MSF3Dprinting/pipe-cross-clamp/tools/sweep_report_body_bolts_2026-09-26.txt

sweep report — pipe_cross_clamp.scad v1.0 (md5 222455b7b1ace6a696c72f4b03150e54) — config body_bolts — 2026-09-26
OpenSCAD 2021.01; check_stl.py on every PASS case. Run in two passes on the same file version (the first pass was
interrupted when the conversation turn ended; the second ran only the unfinished cases). "2 separate pieces" warnings
are expected: the seats split the part below the web.
TOTAL 54 cases: PASS 54  GUARD 0  FAIL 0

PASS   defaults                                   24.2s  check_stl warn: section at Z = 2.0: 2 separate pieces — expected if the part has several legs or walls here, a defect if the zone should be one piece; section at Z = 10.0: 2 separate pieces — expected if the part has several legs or walls here, a defect if the zone should be one piece; section at Z = 40.0: 2 separate pieces — expected if the part has several legs or walls here, a defect if the zone should be one piece
PASS   part=cap1                                  24.1s  check_stl warn: section at Z = 2.0: 2 separate pieces — expected if the part has several legs or walls here, a defect if the zone should be one piece; section at Z = 10.0: 2 separate pieces — expected if the part has several legs or walls here, a defect if the zone should be one piece; section at Z = 40.0: 2 separate pieces — expected if the part has several legs or walls here, a defect if the zone should be one piece
PASS   part=cap2                                  23.9s  check_stl warn: section at Z = 2.0: 2 separate pieces — expected if the part has several legs or walls here, a defect if the zone should be one piece; section at Z = 10.0: 2 separate pieces — expected if the part has several legs or walls here, a defect if the zone should be one piece; section at Z = 40.0: 2 separate pieces — expected if the part has several legs or walls here, a defect if the zone should be one piece
PASS   part=gauge                                 24.5s  check_stl warn: section at Z = 2.0: 2 separate pieces — expected if the part has several legs or walls here, a defect if the zone should be one piece; section at Z = 10.0: 2 separate pieces — expected if the part has several legs or walls here, a defect if the zone should be one piece; section at Z = 40.0: 2 separate pieces — expected if the part has several legs or walls here, a defect if the zone should be one piece
PASS   closure=zipties                            23.6s  check_stl warn: section at Z = 2.0: 2 separate pieces — expected if the part has several legs or walls here, a defect if the zone should be one piece; section at Z = 10.0: 2 separate pieces — expected if the part has several legs or walls here, a defect if the zone should be one piece; section at Z = 40.0: 2 separate pieces — expected if the part has several legs or walls here, a defect if the zone should be one piece
PASS   pipe1_d=min(10)                            24.0s  check_stl warn: section at Z = 2.0: 2 separate pieces — expected if the part has several legs or walls here, a defect if the zone should be one piece
PASS   pipe1_d=max(60)                            26.6s  check_stl warn: section at Z = 2.0: 2 separate pieces — expected if the part has several legs or walls here, a defect if the zone should be one piece; section at Z = 10.0: 2 separate pieces — expected if the part has several legs or walls here, a defect if the zone should be one piece; section at Z = 30.0: 2 separate pieces — expected if the part has several legs or walls here, a defect if the zone should be one piece; section at Z = 40.0: 2 separate pieces — expected if the part has several legs or walls here, a defect if the zone should be one piece
PASS   pipe2_d=min(10)                            27.2s  check_stl warn: section at Z = 2.0: 2 separate pieces — expected if the part has several legs or walls here, a defect if the zone should be one piece; section at Z = 10.0: 2 separate pieces — expected if the part has several legs or walls here, a defect if the zone should be one piece; section at Z = 30.0: 2 separate pieces — expected if the part has several legs or walls here, a defect if the zone should be one piece
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
PASS   corner_r=max(8)                             7.5s  check_stl warn: section at Z = 2.0: 2 separate pieces — expected if the part has several legs or walls here, a defect if the zone should be one piece; section at Z = 10.0: 2 separate pieces — expected if the part has several legs or walls here, a defect if the zone should be one piece; section at Z = 40.0: 2 separate pieces — expected if the part has several legs or walls here, a defect if the zone should be one piece
PASS   show_ghosts=false                           7.4s  check_stl warn: section at Z = 2.0: 2 separate pieces — expected if the part has several legs or walls here, a defect if the zone should be one piece; section at Z = 10.0: 2 separate pieces — expected if the part has several legs or walls here, a defect if the zone should be one piece; section at Z = 40.0: 2 separate pieces — expected if the part has several legs or walls here, a defect if the zone should be one piece
