MSF3Dprinting/pipe-cross-clamp/tools/sweep_report_body_zipties_2026-09-26.txt

sweep report — pipe_cross_clamp.scad v1.0 (md5 222455b7b1ace6a696c72f4b03150e54) — config body_zipties — 2026-09-26
OpenSCAD 2021.01; check_stl.py on every PASS case. Run in two passes on the same file version (the first pass was
interrupted when the conversation turn ended; the second ran only the unfinished cases). "2 separate pieces" warnings
are expected: the seats split the part below the web.
TOTAL 54 cases: PASS 54  GUARD 0  FAIL 0

PASS   defaults                                   27.1s  check_stl warn: section at Z = 2.0: 2 separate pieces — expected if the part has several legs or walls here, a defect if the zone should be one piece; section at Z = 10.0: 2 separate pieces — expected if the part has several legs or walls here, a defect if the zone should be one piece; section at Z = 58.0: 2 separate pieces — expected if the part has several legs or walls here, a defect if the zone should be one piece
PASS   part=cap1                                  26.9s  check_stl warn: section at Z = 2.0: 2 separate pieces — expected if the part has several legs or walls here, a defect if the zone should be one piece; section at Z = 10.0: 2 separate pieces — expected if the part has several legs or walls here, a defect if the zone should be one piece; section at Z = 58.0: 2 separate pieces — expected if the part has several legs or walls here, a defect if the zone should be one piece
PASS   part=cap2                                  27.0s  check_stl warn: section at Z = 2.0: 2 separate pieces — expected if the part has several legs or walls here, a defect if the zone should be one piece; section at Z = 10.0: 2 separate pieces — expected if the part has several legs or walls here, a defect if the zone should be one piece; section at Z = 58.0: 2 separate pieces — expected if the part has several legs or walls here, a defect if the zone should be one piece
PASS   part=gauge                                 27.3s  check_stl warn: section at Z = 2.0: 2 separate pieces — expected if the part has several legs or walls here, a defect if the zone should be one piece; section at Z = 10.0: 2 separate pieces — expected if the part has several legs or walls here, a defect if the zone should be one piece; section at Z = 58.0: 2 separate pieces — expected if the part has several legs or walls here, a defect if the zone should be one piece
PASS   closure=zipties                            27.2s  check_stl warn: section at Z = 2.0: 2 separate pieces — expected if the part has several legs or walls here, a defect if the zone should be one piece; section at Z = 10.0: 2 separate pieces — expected if the part has several legs or walls here, a defect if the zone should be one piece; section at Z = 58.0: 2 separate pieces — expected if the part has several legs or walls here, a defect if the zone should be one piece
PASS   pipe1_d=min(10)                            26.3s  check_stl warn: section at Z = 2.0: 2 separate pieces — expected if the part has several legs or walls here, a defect if the zone should be one piece
PASS   pipe1_d=max(60)                            27.6s  check_stl warn: small bed contact for a tall part — add brim ears (brim_ear_d) or widen the base; section at Z = 2.0: 2 separate pieces — expected if the part has several legs or walls here, a defect if the zone should be one piece; section at Z = 10.0: 2 separate pieces — expected if the part has several legs or walls here, a defect if the zone should be one piece; section at Z = 30.0: 2 separate pieces — expected if the part has several legs or walls here, a defect if the zone should be one piece
PASS   pipe2_d=min(10)                            30.9s  check_stl warn: section at Z = 2.0: 2 separate pieces — expected if the part has several legs or walls here, a defect if the zone should be one piece; section at Z = 10.0: 2 separate pieces — expected if the part has several legs or walls here, a defect if the zone should be one piece
PASS   pipe2_d=max(60)                            30.7s  check_stl warn: small bed contact for a tall part — add brim ears (brim_ear_d) or widen the base; section at Z = 2.0: 2 separate pieces — expected if the part has several legs or walls here, a defect if the zone should be one piece; section at Z = 10.0: 2 separate pieces — expected if the part has several legs or walls here, a defect if the zone should be one piece
PASS   angle=min(0)                               29.7s  check_stl warn: section at Z = 2.0: 2 separate pieces — expected if the part has several legs or walls here, a defect if the zone should be one piece; section at Z = 10.0: 2 separate pieces — expected if the part has several legs or walls here, a defect if the zone should be one piece; section at Z = 50.0: 2 separate pieces — expected if the part has several legs or walls here, a defect if the zone should be one piece
PASS   angle=max(90)                              31.0s  check_stl warn: section at Z = 2.0: 2 separate pieces — expected if the part has several legs or walls here, a defect if the zone should be one piece; section at Z = 10.0: 2 separate pieces — expected if the part has several legs or walls here, a defect if the zone should be one piece; section at Z = 58.0: 2 separate pieces — expected if the part has several legs or walls here, a defect if the zone should be one piece
PASS   seat_len1=min(20)                          31.3s  check_stl warn: small bed contact for a tall part — add brim ears (brim_ear_d) or widen the base; section at Z = 2.0: 2 separate pieces — expected if the part has several legs or walls here, a defect if the zone should be one piece; section at Z = 10.0: 2 separate pieces — expected if the part has several legs or walls here, a defect if the zone should be one piece; section at Z = 58.0: 2 separate pieces — expected if the part has several legs or walls here, a defect if the zone should be one piece
PASS   seat_len1=max(80)                          29.0s  check_stl warn: section at Z = 2.0: 2 separate pieces — expected if the part has several legs or walls here, a defect if the zone should be one piece; section at Z = 10.0: 2 separate pieces — expected if the part has several legs or walls here, a defect if the zone should be one piece; section at Z = 50.0: 2 separate pieces — expected if the part has several legs or walls here, a defect if the zone should be one piece
PASS   seat_len2=min(20)                          31.9s  check_stl warn: section at Z = 2.0: 2 separate pieces — expected if the part has several legs or walls here, a defect if the zone should be one piece; section at Z = 10.0: 2 separate pieces — expected if the part has several legs or walls here, a defect if the zone should be one piece; section at Z = 58.0: 2 separate pieces — expected if the part has several legs or walls here, a defect if the zone should be one piece
PASS   seat_len2=max(80)                          31.7s  check_stl warn: small bed contact for a tall part — add brim ears (brim_ear_d) or widen the base; section at Z = 2.0: 2 separate pieces — expected if the part has several legs or walls here, a defect if the zone should be one piece; section at Z = 10.0: 2 separate pieces — expected if the part has several legs or walls here, a defect if the zone should be one piece
PASS   v_angle=min(60)                            28.5s  check_stl warn: section at Z = 2.0: 2 separate pieces — expected if the part has several legs or walls here, a defect if the zone should be one piece; section at Z = 10.0: 2 separate pieces — expected if the part has several legs or walls here, a defect if the zone should be one piece; section at Z = 30.0: 2 separate pieces — expected if the part has several legs or walls here, a defect if the zone should be one piece
PASS   v_angle=max(90)                            32.0s  check_stl warn: section at Z = 2.0: 2 separate pieces — expected if the part has several legs or walls here, a defect if the zone should be one piece; section at Z = 10.0: 2 separate pieces — expected if the part has several legs or walls here, a defect if the zone should be one piece; section at Z = 58.0: 2 separate pieces — expected if the part has several legs or walls here, a defect if the zone should be one piece
PASS   seat_clear=min(0.5)                        31.0s  check_stl warn: section at Z = 2.0: 2 separate pieces — expected if the part has several legs or walls here, a defect if the zone should be one piece; section at Z = 10.0: 2 separate pieces — expected if the part has several legs or walls here, a defect if the zone should be one piece; section at Z = 50.0: 2 separate pieces — expected if the part has several legs or walls here, a defect if the zone should be one piece; section at Z = 58.0: 2 separate pieces — expected if the part has several legs or walls here, a defect if the zone should be one piece
PASS   seat_clear=max(3)                          31.0s  check_stl warn: small bed contact for a tall part — add brim ears (brim_ear_d) or widen the base; section at Z = 2.0: 2 separate pieces — expected if the part has several legs or walls here, a defect if the zone should be one piece; section at Z = 10.0: 2 separate pieces — expected if the part has several legs or walls here, a defect if the zone should be one piece; section at Z = 58.0: 2 separate pieces — expected if the part has several legs or walls here, a defect if the zone should be one piece
PASS   clamp_gap=min(1)                           31.9s  check_stl warn: section at Z = 2.0: 2 separate pieces — expected if the part has several legs or walls here, a defect if the zone should be one piece; section at Z = 10.0: 2 separate pieces — expected if the part has several legs or walls here, a defect if the zone should be one piece; section at Z = 58.0: 2 separate pieces — expected if the part has several legs or walls here, a defect if the zone should be one piece
PASS   clamp_gap=max(5)                           31.6s  check_stl warn: section at Z = 2.0: 2 separate pieces — expected if the part has several legs or walls here, a defect if the zone should be one piece; section at Z = 10.0: 2 separate pieces — expected if the part has several legs or walls here, a defect if the zone should be one piece; section at Z = 50.0: 2 separate pieces — expected if the part has several legs or walls here, a defect if the zone should be one piece; section at Z = 58.0: 2 separate pieces — expected if the part has several legs or walls here, a defect if the zone should be one piece
PASS   floor_relief=min(0.2)                      31.3s  check_stl warn: section at Z = 2.0: 2 separate pieces — expected if the part has several legs or walls here, a defect if the zone should be one piece; section at Z = 10.0: 2 separate pieces — expected if the part has several legs or walls here, a defect if the zone should be one piece; section at Z = 58.0: 2 separate pieces — expected if the part has several legs or walls here, a defect if the zone should be one piece
PASS   floor_relief=max(2)                        31.2s  check_stl warn: section at Z = 2.0: 2 separate pieces — expected if the part has several legs or walls here, a defect if the zone should be one piece; section at Z = 10.0: 2 separate pieces — expected if the part has several legs or walls here, a defect if the zone should be one piece; section at Z = 58.0: 2 separate pieces — expected if the part has several legs or walls here, a defect if the zone should be one piece
PASS   bolt_clear=min(0.2)                        31.5s  check_stl warn: section at Z = 2.0: 2 separate pieces — expected if the part has several legs or walls here, a defect if the zone should be one piece; section at Z = 10.0: 2 separate pieces — expected if the part has several legs or walls here, a defect if the zone should be one piece; section at Z = 58.0: 2 separate pieces — expected if the part has several legs or walls here, a defect if the zone should be one piece
PASS   bolt_clear=max(1.2)                        31.3s  check_stl warn: section at Z = 2.0: 2 separate pieces — expected if the part has several legs or walls here, a defect if the zone should be one piece; section at Z = 10.0: 2 separate pieces — expected if the part has several legs or walls here, a defect if the zone should be one piece; section at Z = 58.0: 2 separate pieces — expected if the part has several legs or walls here, a defect if the zone should be one piece
PASS   tie_w=min(2.5)                             31.8s  check_stl warn: section at Z = 2.0: 2 separate pieces — expected if the part has several legs or walls here, a defect if the zone should be one piece; section at Z = 10.0: 2 separate pieces — expected if the part has several legs or walls here, a defect if the zone should be one piece; section at Z = 50.0: 2 separate pieces — expected if the part has several legs or walls here, a defect if the zone should be one piece
PASS   tie_w=max(9)                               32.2s  check_stl warn: small bed contact for a tall part — add brim ears (brim_ear_d) or widen the base; section at Z = 2.0: 2 separate pieces — expected if the part has several legs or walls here, a defect if the zone should be one piece; section at Z = 10.0: 2 separate pieces — expected if the part has several legs or walls here, a defect if the zone should be one piece; section at Z = 58.0: 2 separate pieces — expected if the part has several legs or walls here, a defect if the zone should be one piece
PASS   tie_t=min(0.8)                             32.0s  check_stl warn: section at Z = 2.0: 2 separate pieces — expected if the part has several legs or walls here, a defect if the zone should be one piece; section at Z = 10.0: 2 separate pieces — expected if the part has several legs or walls here, a defect if the zone should be one piece; section at Z = 50.0: 2 separate pieces — expected if the part has several legs or walls here, a defect if the zone should be one piece; section at Z = 58.0: 2 separate pieces — expected if the part has several legs or walls here, a defect if the zone should be one piece
PASS   tie_t=max(2.5)                             31.0s  check_stl warn: section at Z = 2.0: 2 separate pieces — expected if the part has several legs or walls here, a defect if the zone should be one piece; section at Z = 10.0: 2 separate pieces — expected if the part has several legs or walls here, a defect if the zone should be one piece; section at Z = 58.0: 2 separate pieces — expected if the part has several legs or walls here, a defect if the zone should be one piece
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
PASS   tie_bend_r=max(10)                         13.4s  check_stl warn: section at Z = 2.0: 2 separate pieces — expected if the part has several legs or walls here, a defect if the zone should be one piece; section at Z = 10.0: 2 separate pieces — expected if the part has several legs or walls here, a defect if the zone should be one piece; section at Z = 58.0: 2 separate pieces — expected if the part has several legs or walls here, a defect if the zone should be one piece
PASS   corner_r=min(2)                            12.8s  check_stl warn: section at Z = 2.0: 2 separate pieces — expected if the part has several legs or walls here, a defect if the zone should be one piece; section at Z = 10.0: 2 separate pieces — expected if the part has several legs or walls here, a defect if the zone should be one piece; section at Z = 58.0: 2 separate pieces — expected if the part has several legs or walls here, a defect if the zone should be one piece
PASS   corner_r=max(8)                            13.1s  check_stl warn: section at Z = 2.0: 2 separate pieces — expected if the part has several legs or walls here, a defect if the zone should be one piece; section at Z = 10.0: 2 separate pieces — expected if the part has several legs or walls here, a defect if the zone should be one piece; section at Z = 58.0: 2 separate pieces — expected if the part has several legs or walls here, a defect if the zone should be one piece
PASS   show_ghosts=false                          13.1s  check_stl warn: section at Z = 2.0: 2 separate pieces — expected if the part has several legs or walls here, a defect if the zone should be one piece; section at Z = 10.0: 2 separate pieces — expected if the part has several legs or walls here, a defect if the zone should be one piece; section at Z = 58.0: 2 separate pieces — expected if the part has several legs or walls here, a defect if the zone should be one piece
