MSF3Dprinting/pipe-cross-clamp/tools/sweep_report_cap2_2026-09-26.txt

sweep report — pipe_cross_clamp.scad v1.0 (md5 222455b7b1ace6a696c72f4b03150e54) — config cap2 — 2026-09-26
OpenSCAD 2021.01; check_stl.py on every PASS case. Run in two passes on the same file version (the first pass was
interrupted when the conversation turn ended; the second ran only the unfinished cases). "2 separate pieces" warnings
are expected: the seats split the part below the web.
TOTAL 54 cases: PASS 54  GUARD 0  FAIL 0

PASS   defaults                                   26.3s  check_stl warn: section at Z = 2.0: 2 separate pieces — expected if the part has several legs or walls here, a defect if the zone should be one piece; section at Z = 10.0: 2 separate pieces — expected if the part has several legs or walls here, a defect if the zone should be one piece
PASS   part=cap1                                  26.7s  check_stl warn: section at Z = 2.0: 2 separate pieces — expected if the part has several legs or walls here, a defect if the zone should be one piece; section at Z = 10.0: 2 separate pieces — expected if the part has several legs or walls here, a defect if the zone should be one piece
PASS   part=cap2                                  26.3s  check_stl warn: section at Z = 2.0: 2 separate pieces — expected if the part has several legs or walls here, a defect if the zone should be one piece; section at Z = 10.0: 2 separate pieces — expected if the part has several legs or walls here, a defect if the zone should be one piece
PASS   part=gauge                                 26.0s  check_stl warn: section at Z = 2.0: 2 separate pieces — expected if the part has several legs or walls here, a defect if the zone should be one piece; section at Z = 10.0: 2 separate pieces — expected if the part has several legs or walls here, a defect if the zone should be one piece
PASS   closure=zipties                            26.6s  check_stl warn: section at Z = 2.0: 2 separate pieces — expected if the part has several legs or walls here, a defect if the zone should be one piece; section at Z = 10.0: 2 separate pieces — expected if the part has several legs or walls here, a defect if the zone should be one piece
PASS   pipe1_d=min(10)                            27.3s  check_stl warn: section at Z = 2.0: 2 separate pieces — expected if the part has several legs or walls here, a defect if the zone should be one piece; section at Z = 10.0: 2 separate pieces — expected if the part has several legs or walls here, a defect if the zone should be one piece
PASS   pipe1_d=max(60)                            26.9s  check_stl warn: section at Z = 2.0: 2 separate pieces — expected if the part has several legs or walls here, a defect if the zone should be one piece; section at Z = 10.0: 2 separate pieces — expected if the part has several legs or walls here, a defect if the zone should be one piece
PASS   pipe2_d=min(10)                            26.2s  check_stl warn: section at Z = 2.0: 2 separate pieces — expected if the part has several legs or walls here, a defect if the zone should be one piece
PASS   pipe2_d=max(60)                            26.5s  check_stl warn: section at Z = 2.0: 2 separate pieces — expected if the part has several legs or walls here, a defect if the zone should be one piece; section at Z = 10.0: 2 separate pieces — expected if the part has several legs or walls here, a defect if the zone should be one piece
PASS   angle=min(0)                               30.6s  check_stl warn: section at Z = 2.0: 2 separate pieces — expected if the part has several legs or walls here, a defect if the zone should be one piece; section at Z = 10.0: 2 separate pieces — expected if the part has several legs or walls here, a defect if the zone should be one piece
PASS   angle=max(90)                              30.5s  check_stl warn: section at Z = 2.0: 2 separate pieces — expected if the part has several legs or walls here, a defect if the zone should be one piece; section at Z = 10.0: 2 separate pieces — expected if the part has several legs or walls here, a defect if the zone should be one piece
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
PASS   channel_wall=max(3.6)                      22.4s  check_stl warn: section at Z = 2.0: 2 separate pieces — expected if the part has several legs or walls here, a defect if the zone should be one piece; section at Z = 10.0: 2 separate pieces — expected if the part has several legs or walls here, a defect if the zone should be one piece
PASS   tie_bend_r=min(5.5)                        22.4s  check_stl warn: section at Z = 2.0: 2 separate pieces — expected if the part has several legs or walls here, a defect if the zone should be one piece; section at Z = 10.0: 2 separate pieces — expected if the part has several legs or walls here, a defect if the zone should be one piece
PASS   tie_bend_r=max(10)                         21.3s  check_stl warn: section at Z = 2.0: 2 separate pieces — expected if the part has several legs or walls here, a defect if the zone should be one piece; section at Z = 10.0: 2 separate pieces — expected if the part has several legs or walls here, a defect if the zone should be one piece
PASS   corner_r=min(2)                            21.4s  check_stl warn: section at Z = 2.0: 2 separate pieces — expected if the part has several legs or walls here, a defect if the zone should be one piece; section at Z = 10.0: 2 separate pieces — expected if the part has several legs or walls here, a defect if the zone should be one piece
PASS   corner_r=max(8)                            21.8s  check_stl warn: section at Z = 2.0: 2 separate pieces — expected if the part has several legs or walls here, a defect if the zone should be one piece; section at Z = 10.0: 2 separate pieces — expected if the part has several legs or walls here, a defect if the zone should be one piece
PASS   show_ghosts=false                          17.3s  check_stl warn: section at Z = 2.0: 2 separate pieces — expected if the part has several legs or walls here, a defect if the zone should be one piece; section at Z = 10.0: 2 separate pieces — expected if the part has several legs or walls here, a defect if the zone should be one piece
