MSF3Dprinting/pipe-cross-clamp/tools/sweep_report_combo_2026-09-26.txt

sweep report — pipe_cross_clamp.scad v1.0 (md5 222455b7b1ace6a696c72f4b03150e54) — config combo — 2026-09-26
OpenSCAD 2021.01; check_stl.py on every PASS case. Run in two passes on the same file version (the first pass was
interrupted when the conversation turn ended; the second ran only the unfinished cases). "2 separate pieces" warnings
are expected: the seats split the part below the web.
TOTAL 80 cases: PASS 80  GUARD 0  FAIL 0

PASS   bolts_body_10x60_a0                        24.9s  check_stl warn: section at Z = 2.0: 2 separate pieces — expected if the part has several legs or walls here, a defect if the zone should be one piece; section at Z = 30.0: 2 separate pieces — expected if the part has several legs or walls here, a defect if the zone should be one piece
PASS   bolts_cap1_10x60_a0                        27.7s  check_stl warn: section at Z = 2.0: 2 separate pieces — expected if the part has several legs or walls here, a defect if the zone should be one piece
PASS   bolts_cap2_10x60_a0                        27.5s  check_stl warn: section at Z = 2.0: 2 separate pieces — expected if the part has several legs or walls here, a defect if the zone should be one piece; section at Z = 10.0: 2 separate pieces — expected if the part has several legs or walls here, a defect if the zone should be one piece; section at Z = 30.0: 2 separate pieces — expected if the part has several legs or walls here, a defect if the zone should be one piece
PASS   bolts_body_10x60_a15                       25.4s  check_stl warn: section at Z = 2.0: 2 separate pieces — expected if the part has several legs or walls here, a defect if the zone should be one piece; section at Z = 30.0: 2 separate pieces — expected if the part has several legs or walls here, a defect if the zone should be one piece
PASS   bolts_cap1_10x60_a15                       26.7s  check_stl warn: section at Z = 2.0: 2 separate pieces — expected if the part has several legs or walls here, a defect if the zone should be one piece
PASS   bolts_cap2_10x60_a15                       27.6s  check_stl warn: section at Z = 2.0: 2 separate pieces — expected if the part has several legs or walls here, a defect if the zone should be one piece; section at Z = 10.0: 2 separate pieces — expected if the part has several legs or walls here, a defect if the zone should be one piece; section at Z = 30.0: 2 separate pieces — expected if the part has several legs or walls here, a defect if the zone should be one piece
PASS   bolts_body_10x60_a45                       25.2s  check_stl warn: section at Z = 2.0: 2 separate pieces — expected if the part has several legs or walls here, a defect if the zone should be one piece; section at Z = 30.0: 2 separate pieces — expected if the part has several legs or walls here, a defect if the zone should be one piece
PASS   bolts_cap1_10x60_a45                       27.1s  check_stl warn: section at Z = 2.0: 2 separate pieces — expected if the part has several legs or walls here, a defect if the zone should be one piece
PASS   bolts_cap2_10x60_a45                       32.5s  check_stl warn: section at Z = 2.0: 2 separate pieces — expected if the part has several legs or walls here, a defect if the zone should be one piece; section at Z = 10.0: 2 separate pieces — expected if the part has several legs or walls here, a defect if the zone should be one piece; section at Z = 30.0: 2 separate pieces — expected if the part has several legs or walls here, a defect if the zone should be one piece
PASS   bolts_body_10x60_a90                       27.7s  check_stl warn: section at Z = 2.0: 2 separate pieces — expected if the part has several legs or walls here, a defect if the zone should be one piece; section at Z = 30.0: 2 separate pieces — expected if the part has several legs or walls here, a defect if the zone should be one piece
PASS   bolts_cap1_10x60_a90                       30.1s  check_stl warn: section at Z = 2.0: 2 separate pieces — expected if the part has several legs or walls here, a defect if the zone should be one piece
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
PASS   bolts_body_32x25_a45                       12.2s  check_stl warn: section at Z = 2.0: 2 separate pieces — expected if the part has several legs or walls here, a defect if the zone should be one piece; section at Z = 10.0: 2 separate pieces — expected if the part has several legs or walls here, a defect if the zone should be one piece
PASS   bolts_cap1_32x25_a45                       13.2s  check_stl warn: section at Z = 2.0: 2 separate pieces — expected if the part has several legs or walls here, a defect if the zone should be one piece; section at Z = 10.0: 2 separate pieces — expected if the part has several legs or walls here, a defect if the zone should be one piece
PASS   bolts_cap2_32x25_a45                       13.2s  check_stl warn: section at Z = 2.0: 2 separate pieces — expected if the part has several legs or walls here, a defect if the zone should be one piece; section at Z = 10.0: 2 separate pieces — expected if the part has several legs or walls here, a defect if the zone should be one piece
PASS   bolts_body_32x25_a90                       11.6s  check_stl warn: section at Z = 2.0: 2 separate pieces — expected if the part has several legs or walls here, a defect if the zone should be one piece; section at Z = 10.0: 2 separate pieces — expected if the part has several legs or walls here, a defect if the zone should be one piece
PASS   bolts_cap1_32x25_a90                       13.3s  check_stl warn: section at Z = 2.0: 2 separate pieces — expected if the part has several legs or walls here, a defect if the zone should be one piece; section at Z = 10.0: 2 separate pieces — expected if the part has several legs or walls here, a defect if the zone should be one piece
PASS   bolts_cap2_32x25_a90                       12.8s  check_stl warn: section at Z = 2.0: 2 separate pieces — expected if the part has several legs or walls here, a defect if the zone should be one piece; section at Z = 10.0: 2 separate pieces — expected if the part has several legs or walls here, a defect if the zone should be one piece
PASS   zipties_body_10x60_a0                      12.9s  check_stl warn: section at Z = 2.0: 2 separate pieces — expected if the part has several legs or walls here, a defect if the zone should be one piece
PASS   zipties_body_10x60_a15                     15.6s  check_stl warn: section at Z = 2.0: 2 separate pieces — expected if the part has several legs or walls here, a defect if the zone should be one piece
PASS   zipties_body_10x60_a45                     14.7s  check_stl warn: small bed contact for a tall part — add brim ears (brim_ear_d) or widen the base; section at Z = 2.0: 2 separate pieces — expected if the part has several legs or walls here, a defect if the zone should be one piece
PASS   zipties_body_10x60_a90                     12.9s  check_stl warn: section at Z = 2.0: 2 separate pieces — expected if the part has several legs or walls here, a defect if the zone should be one piece
PASS   zipties_body_60x10_a0                      12.2s  check_stl warn: section at Z = 2.0: 2 separate pieces — expected if the part has several legs or walls here, a defect if the zone should be one piece; section at Z = 10.0: 2 separate pieces — expected if the part has several legs or walls here, a defect if the zone should be one piece; section at Z = 30.0: 2 separate pieces — expected if the part has several legs or walls here, a defect if the zone should be one piece
PASS   zipties_body_60x10_a15                     14.9s  check_stl warn: small bed contact for a tall part — add brim ears (brim_ear_d) or widen the base; section at Z = 2.0: 2 separate pieces — expected if the part has several legs or walls here, a defect if the zone should be one piece; section at Z = 10.0: 2 separate pieces — expected if the part has several legs or walls here, a defect if the zone should be one piece; section at Z = 30.0: 2 separate pieces — expected if the part has several legs or walls here, a defect if the zone should be one piece
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
PASS   zipties_body_32x25_a0                       3.9s  check_stl warn: section at Z = 2.0: 2 separate pieces — expected if the part has several legs or walls here, a defect if the zone should be one piece; section at Z = 10.0: 2 separate pieces — expected if the part has several legs or walls here, a defect if the zone should be one piece
PASS   zipties_body_32x25_a15                      4.7s  check_stl warn: section at Z = 2.0: 2 separate pieces — expected if the part has several legs or walls here, a defect if the zone should be one piece; section at Z = 10.0: 2 separate pieces — expected if the part has several legs or walls here, a defect if the zone should be one piece
PASS   zipties_body_32x25_a45                      4.1s  check_stl warn: section at Z = 2.0: 2 separate pieces — expected if the part has several legs or walls here, a defect if the zone should be one piece; section at Z = 10.0: 2 separate pieces — expected if the part has several legs or walls here, a defect if the zone should be one piece
PASS   zipties_body_32x25_a90                      4.0s  check_stl warn: section at Z = 2.0: 2 separate pieces — expected if the part has several legs or walls here, a defect if the zone should be one piece; section at Z = 10.0: 2 separate pieces — expected if the part has several legs or walls here, a defect if the zone should be one piece
