MSF3Dprinting/pipe-cross-clamp/tools/sweep_report_lists_v1.2_2026-09-26.txt

sweep of ../pipe_cross_clamp.scad — 16 cases — 2026-09-26 13:10
PASS   bolts_body_M5                               3.7s  check_stl warn: section at Z = 2.0: 2 separate pieces — expected if the part has several legs or walls here, a defect if the zone should be one piece; section at Z = 10.0: 2 separate pieces — expected if the part has several legs or walls here, a defect if the zone should be one piece
PASS   bolts_body_M6                               3.7s  check_stl warn: section at Z = 2.0: 2 separate pieces — expected if the part has several legs or walls here, a defect if the zone should be one piece; section at Z = 10.0: 2 separate pieces — expected if the part has several legs or walls here, a defect if the zone should be one piece
PASS   bolts_body_M8                               3.7s  check_stl warn: section at Z = 2.0: 2 separate pieces — expected if the part has several legs or walls here, a defect if the zone should be one piece; section at Z = 10.0: 2 separate pieces — expected if the part has several legs or walls here, a defect if the zone should be one piece
PASS   bolts_cap1_M5                               3.9s  check_stl warn: section at Z = 2.0: 2 separate pieces — expected if the part has several legs or walls here, a defect if the zone should be one piece; section at Z = 10.0: 2 separate pieces — expected if the part has several legs or walls here, a defect if the zone should be one piece
PASS   bolts_cap1_M6                               3.9s  check_stl warn: section at Z = 2.0: 2 separate pieces — expected if the part has several legs or walls here, a defect if the zone should be one piece; section at Z = 10.0: 2 separate pieces — expected if the part has several legs or walls here, a defect if the zone should be one piece
PASS   bolts_cap1_M8                               3.8s  check_stl warn: section at Z = 2.0: 2 separate pieces — expected if the part has several legs or walls here, a defect if the zone should be one piece; section at Z = 10.0: 2 separate pieces — expected if the part has several legs or walls here, a defect if the zone should be one piece
PASS   bolts_cap2_M5                               3.9s  check_stl warn: section at Z = 2.0: 2 separate pieces — expected if the part has several legs or walls here, a defect if the zone should be one piece; section at Z = 10.0: 2 separate pieces — expected if the part has several legs or walls here, a defect if the zone should be one piece
PASS   bolts_cap2_M6                               4.0s  check_stl warn: section at Z = 2.0: 2 separate pieces — expected if the part has several legs or walls here, a defect if the zone should be one piece; section at Z = 10.0: 2 separate pieces — expected if the part has several legs or walls here, a defect if the zone should be one piece
PASS   bolts_cap2_M8                               4.0s  check_stl warn: section at Z = 2.0: 2 separate pieces — expected if the part has several legs or walls here, a defect if the zone should be one piece; section at Z = 10.0: 2 separate pieces — expected if the part has several legs or walls here, a defect if the zone should be one piece
PASS   bolts_gauge_M5                              2.5s  
PASS   bolts_gauge_M6                              2.4s  
PASS   bolts_gauge_M8                              2.3s  
PASS   zipties_body                                4.0s  check_stl warn: section at Z = 2.0: 2 separate pieces — expected if the part has several legs or walls here, a defect if the zone should be one piece; section at Z = 10.0: 2 separate pieces — expected if the part has several legs or walls here, a defect if the zone should be one piece
PASS   zipties_gauge                               2.3s  
GUARD  zipties_cap1                                0.0s  ERROR: Assertion '((is_bolts || (part == "body")) || (part == "gauge"))' failed: "the zip-tie variant has no caps - choose part = body or gauge" in file pipe_cross_clamp.scad, line 189
GUARD  zipties_cap2                                0.0s  ERROR: Assertion '((is_bolts || (part == "body")) || (part == "gauge"))' failed: "the zip-tie variant has no caps - choose part = body or gauge" in file pipe_cross_clamp.scad, line 189
SUMMARY: 14 PASS, 2 GUARD, 0 FAIL of 16
