MSF3Dprinting/pipe-cross-clamp/tools/sweep_report_v1.4_2026-09-26.txt

sweep report — pipe_cross_clamp.scad v1.4 (md5 a9ba3d7b783dce96604d782529b1ea28) — bolts variant after the cap / bolt redesign — 2026-09-26
Cases: body, cap 1, cap 2 at every 10 deg 0-90; Ø10/60 pairs at 0/45/90; min and max of bolt_tool_d, floor_t, cap_back,
seat_len1/2, v_angle, clamp_gap, seat_clear, seat_wall, web, bolt_clear; M5 and M8; all-parts plates. check_stl.py on every
PASS case, sections at Z 1, 8, 16, 24 (plates with their own body count). Run in passes on the same file version.
TOTAL 154 cases: PASS 151  GUARD 3  FAIL 0   (GUARD = Ø60 x Ø60 plates that do not fit the bed)

PASS   body_a0                                     5.2s  check_stl warn: section at Z = 1.0: 2 separate pieces — expected if the part has several legs or walls here, a defect if the zone should be one piece; section at Z = 8.0: 2 separate pieces — expected if the part has several legs or walls here, a defect if the zone should be one piece; section at Z = 16.0: 2 separate pieces — expected if the part has several legs or walls here, a defect if the zone should be one piece
PASS   cap1_a0                                     6.3s  check_stl warn: section at Z = 1.0: 2 separate pieces — expected if the part has several legs or walls here, a defect if the zone should be one piece; section at Z = 8.0: 2 separate pieces — expected if the part has several legs or walls here, a defect if the zone should be one piece; section at Z = 16.0: 2 separate pieces — expected if the part has several legs or walls here, a defect if the zone should be one piece
PASS   cap2_a0                                     3.5s  check_stl warn: section at Z = 1.0: 2 separate pieces — expected if the part has several legs or walls here, a defect if the zone should be one piece; section at Z = 8.0: 2 separate pieces — expected if the part has several legs or walls here, a defect if the zone should be one piece; section at Z = 16.0: 2 separate pieces — expected if the part has several legs or walls here, a defect if the zone should be one piece
PASS   body_a10                                    5.2s  check_stl warn: section at Z = 1.0: 2 separate pieces — expected if the part has several legs or walls here, a defect if the zone should be one piece; section at Z = 8.0: 2 separate pieces — expected if the part has several legs or walls here, a defect if the zone should be one piece; section at Z = 16.0: 2 separate pieces — expected if the part has several legs or walls here, a defect if the zone should be one piece
PASS   cap1_a10                                    6.5s  check_stl warn: section at Z = 1.0: 2 separate pieces — expected if the part has several legs or walls here, a defect if the zone should be one piece; section at Z = 8.0: 2 separate pieces — expected if the part has several legs or walls here, a defect if the zone should be one piece; section at Z = 16.0: 2 separate pieces — expected if the part has several legs or walls here, a defect if the zone should be one piece
PASS   cap2_a10                                    3.8s  check_stl warn: section at Z = 1.0: 2 separate pieces — expected if the part has several legs or walls here, a defect if the zone should be one piece; section at Z = 8.0: 2 separate pieces — expected if the part has several legs or walls here, a defect if the zone should be one piece; section at Z = 16.0: 2 separate pieces — expected if the part has several legs or walls here, a defect if the zone should be one piece
PASS   body_a20                                    5.0s  check_stl warn: section at Z = 1.0: 2 separate pieces — expected if the part has several legs or walls here, a defect if the zone should be one piece; section at Z = 8.0: 2 separate pieces — expected if the part has several legs or walls here, a defect if the zone should be one piece; section at Z = 16.0: 2 separate pieces — expected if the part has several legs or walls here, a defect if the zone should be one piece
PASS   cap1_a20                                    6.7s  check_stl warn: section at Z = 1.0: 2 separate pieces — expected if the part has several legs or walls here, a defect if the zone should be one piece; section at Z = 8.0: 2 separate pieces — expected if the part has several legs or walls here, a defect if the zone should be one piece; section at Z = 16.0: 2 separate pieces — expected if the part has several legs or walls here, a defect if the zone should be one piece
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
PASS   all_checks_bolts_60x10_a0                  43.3s  check_stl warn: section at Z = 1.0: 8 separate pieces — expected if the part has several legs or walls here, a defect if the zone should be one piece; section at Z = 8.0: 5 separate pieces — expected if the part has several legs or walls here, a defect if the zone should be one piece; section at Z = 16.0: 4 separate pieces — expected if the part has several legs or walls here, a defect if the zone should be one piece; section at Z = 24.0: 4 separate pieces — expected if the part has several legs or walls here, a defect if the zone should be one piece
PASS   all_bolts_60x10_a90                        27.3s  check_stl warn: section at Z = 1.0: 6 separate pieces — expected if the part has several legs or walls here, a defect if the zone should be one piece; section at Z = 8.0: 5 separate pieces — expected if the part has several legs or walls here, a defect if the zone should be one piece; section at Z = 16.0: 4 separate pieces — expected if the part has several legs or walls here, a defect if the zone should be one piece; section at Z = 24.0: 4 separate pieces — expected if the part has several legs or walls here, a defect if the zone should be one piece
PASS   all_checks_bolts_60x10_a90                 40.9s  check_stl warn: section at Z = 1.0: 8 separate pieces — expected if the part has several legs or walls here, a defect if the zone should be one piece; section at Z = 8.0: 5 separate pieces — expected if the part has several legs or walls here, a defect if the zone should be one piece; section at Z = 16.0: 4 separate pieces — expected if the part has several legs or walls here, a defect if the zone should be one piece; section at Z = 24.0: 4 separate pieces — expected if the part has several legs or walls here, a defect if the zone should be one piece
PASS   all_bolts_60x60_a0                         27.7s  check_stl warn: section at Z = 1.0: 6 separate pieces — expected if the part has several legs or walls here, a defect if the zone should be one piece; section at Z = 8.0: 6 separate pieces — expected if the part has several legs or walls here, a defect if the zone should be one piece; section at Z = 16.0: 6 separate pieces — expected if the part has several legs or walls here, a defect if the zone should be one piece; section at Z = 24.0: 6 separate pieces — expected if the part has several legs or walls here, a defect if the zone should be one piece
GUARD  all_checks_bolts_60x60_a0                   0.0s  ERROR: Assertion '(!is_plate || ((plate_w <= (use_w + 0.001)) && (plate_h <= (use_h + 0.001))))' failed: "the parts do not fit on one print plate (250 x 210 mm bed) - choose the parts one by one" in file pipe_cross_clamp.scad, line 249
GUARD  all_bolts_60x60_a90                         0.0s  ERROR: Assertion '(!is_plate || ((plate_w <= (use_w + 0.001)) && (plate_h <= (use_h + 0.001))))' failed: "the parts do not fit on one print plate (250 x 210 mm bed) - choose the parts one by one" in file pipe_cross_clamp.scad, line 249
GUARD  all_checks_bolts_60x60_a90                  0.0s  ERROR: Assertion '(!is_plate || ((plate_w <= (use_w + 0.001)) && (plate_h <= (use_h + 0.001))))' failed: "the parts do not fit on one print plate (250 x 210 mm bed) - choose the parts one by one" in file pipe_cross_clamp.scad, line 249
