MSF3Dprinting/pipe-cross-clamp/STATUS.md

# STATUS — Pipe cross clamp, fixed angle   (one page; update at the end of every conversation)

**Version:** 1.5 · **Stage:** 6 of 9 (delivered, fits not confirmed) · **Next step:** measure both pipes, then print the coupon and two gauges; reply with the coupon code and the gauge gap.

## Stages
| Stage | Status | Date | Note |
|---|---|---|---|
| 0 Intake | done | 2026-09-26 | 2 rounds (owner as requester) |
| 1 Request summary | done | 2026-09-26 | "yes" |
| 2 Design brief v0.1 | done | 2026-09-26 | "yes proceed" |
| 3 Design plan | done | 2026-09-26 | written alongside the model (§2.1) |
| 4 Model + coupon + gauge | done | 2026-09-26 | bolts and zip-tie variants, caps, gauge |
| 5 Verification | done | 2026-09-26 | v1.4: 154-case sweep 151 PASS / 3 GUARD / 0 FAIL; all 10 STLs Manifold-valid; T15 slicer not run |
| 6 Delivery | done | 2026-09-26 | pipe_cross_clamp_v1.0.zip |
| 6f Customizer header | done | 2026-09-26 | v1.5: @name / @description / @category / @credit / @license header in the one-file version; meshes identical to 1.4 |
| 6e Stronger caps | done | 2026-09-26 | v1.4: 4 through-bolts (2 per side of each pipe), solid convex caps (no wings), counterbores + captive-nut wells, 10 mm over the apex; requester review: old caps too weak, wobbly, would delaminate |
| 6d All-parts plate | done | 2026-09-26 | v1.3: "all" plate options, numbered gauges, plate STLs; part meshes identical to 1.2 |
| 6c Customizer usability | done | 2026-09-26 | v1.2: lists for choices, sliders for numbers; meshes identical to 1.1 |
| 6b Update to new project rules | done | 2026-09-26 | v1.1: one-file Customizer, README + DATASHEET, no licence text, follow-up schedule, Manifold validation; meshes identical to 1.0 |
| 7 Coupon and first article | pending | | |
| 8 Use test | pending | | 4 kg for 10 min, per README |
| 9 Revision & release | pending | | |

## Files
| File | Version | Purpose |
|---|---|---|
| pipe_cross_clamp.scad | 1.4 | parametric source, all parts |
| pipe_cross_clamp_customizer.scad | 1.4 | one-file Customizer version (generated by tools/make_customizer.py — regenerate after every edit) |
| pipe_cross_clamp_context.scad | 1.4 | context / exploded / section renders only |
| pipe_cross_clamp_coupon.scad | 1.4 | tie-slot and bolt-hole coupon |
| common.scad, helpers.scad | skill v1.2.0 | shared defaults and helpers (unchanged) |
| stl/*.stl, stl/EXPORT_LOG.txt | 1.4 | print-ready STLs and their parameter sets |
| README.md | 1.4 | short visual guide |
| DATASHEET.md | 1.4 | full MSF datasheet, verification, risks, follow-up schedule |
| brief/design_brief.md, brief/design_plan.md | 0.1 / 1.0 | brief as approved; plan |

## Confirmed by test print
| Value | Default | Confirmed | Source (coupon code / first article / load test) |
|---|---|---|---|
| pipe1_d | 32 (UNVERIFIED) | — | not confirmed — measure |
| pipe2_d | 25 (UNVERIFIED) | — | not confirmed — measure |
| tie_w × tie_t | 6.0 × 1.6 (UNVERIFIED) | — | not confirmed — measure |
| tie_clear | 0.5 | — | not confirmed (coupon row 1) |
| bolt_clear | 0.6 | — | not confirmed (coupon row 2) |
| clamp_gap / seat fit | 3.0 | — | not confirmed (gauge gap) |
| grip at 4 kg | — | — | not confirmed (use test) |

## Deviations from the brief (found while modelling — fold into the brief at the end)
- **Body size and seat length.** Bolt-variant body seats lengthen automatically so the bolt bosses never stick out past a seat end (61 / 68 mm at the defaults; `seat_len` becomes a minimum). An oblique end would leave knife edges at the seat mouths.
- **Body height.** The body is built as a lower block (seat 1) + 45° transition + upper block (seat 2); the transition height is computed from the overhang. The body is 42.8 mm tall instead of about 38, so the bolts are M6 × 75 or M6 × 80 (72 mm minimum) instead of about M6 × 70.
- **Corner radius.** Seat-end corners have a 0.5–1.2 mm radius instead of 4 mm, which would thin the seat wall to 0.25 mm. In the zip-tie variant the block corner radius is also limited by the tie slots: 4 / 1.75 mm at the defaults; R4 in the upper block would leave about 0.9 mm beside the pipe-2 slots. Recorded as a design-rule deviation.
- **Tie-channel bend radius.** `tie_bend_r` is a minimum; it grows automatically for wide ties (instead of a guard refusing them).
- **Transition height.** Computed from the exact (rounded) outline of the lower block — the sharp-corner estimate gave 45.7° at `seat_len2` = 80.
- **Gauge notches.** Now exact through the plate thickness; the first version was 1.4–1.8 mm oversize because one hull spanned both face flares.
- **Caps and bolts (v1.4, after requester review).** Four through-bolts instead of two (two diagonal bolts put every clamping force on one line, so the clamp could rock about it); layout "corners" or "pairs" by angle, whichever is more compact. Bosses keep the full bolt wall at the top face. The v1.0–1.3 caps (a hump with two 6 mm wings and 4 mm over the V apex) were too weak: the wings flexed (wobble), the wing roots would delaminate, and the section over the apex reached about 50 MPa at 300 N per bolt. Each cap is now one solid convex block with counterbores (cap 1) or captive-nut hex wells (cap 2), 8 mm floors, and 10 mm over the apex (about 8 MPa). Washer and nut sizes now follow the bolt size list (ISO 7089 / 4032); `washer_d`, `washer_t`, `nut_h`, `flange_t` removed; `bolt_tool_d`, `floor_t` added.
- **`bolt_clear` meaning.** It is the total extra on the hole diameter, including the vertical-hole compensation (default 0.6), so the coupon letter maps directly to it.
- **Size label.** Moved from the body to the gauge (debossed diameters); no clean text area exists on the body at every angle.
- **Zip-tie body size.** 48 × 54 × 62 mm; its tie channels are U-shaped with 45° gabled roofs and 6 mm bends.
- **Context scene.** Uses `include` with a `build_part` switch instead of `use`, so the Customizer overrides reach the scene.

## Rule updates applied (v1.1, new project instructions of 26 Sep 2026)
- One-file Customizer version added; README split into a short visual README + full DATASHEET; licence statements and the LICENSE file removed.
- Follow-up schedule (2 weeks, 1 month, 3 months, then every 3 months) added — **proposed, awaiting advisor validation**.
- **Readiness levels pending:** `references/readiness-levels.md` (Humanitarian Making scale) is not in the installed skill package; evidence is written, levels are not.
- **Export engine:** `openscad-fast` (Manifold) not available in the sandbox; exported with OpenSCAD 2021.01 (CGAL) and validated with manifold3d 3.5.4.
- The installed skill package is still 1.2.0 and its `docs/PROJECT_INSTRUCTIONS.md` is the older text; only the Project instructions carry the new rules.

## For the skill maintainers (found on this item)
- **Customizer comments:** OpenSCAD builds a list or slider only when the comment after the value is nothing but the `[spec]`; any text after it gives a plain text box. Put the description on the line above (it becomes the label). The skill's `scad/test_coupon.scad` has the same problem (fixed in this item's coupon copy). `tools/fix_customizer_comments.py` converts a file.
- **Requester preference:** choices as lists (labelled `[value:Label, …]`), numbers as sliders where a range makes sense.
- **`scripts/sweep.py` bug:** any spec containing `:` was read as a range, so labelled lists (`[body:Body, …]`) were mis-read or skipped, and numeric lists were quoted. Patched in this item's `tools/sweep.py` (range = numbers only; quote only string parameters) — please merge into the skill.

- **Multi-part plates:** `scripts/export.sh` and `scripts/sweep.py` assumed one body per STL. Patched in this item's copies: a model may announce its limits with `echo("CHECK expect_bodies=N max_size=M")`, and both scripts pass them to `check_stl.py`. Please merge into the skill.
- **Requester preference:** the part list always offers "all printable parts" as one option.

- **Lesson (for references/lessons.md):** check the section over a clamp's V apex, not only the flange root; never put bolt load into a thin wing that joins a taller block with an inside corner — layers peel there; never clamp with two diagonal bolts — use two per side so no line of bolts exists to rock about; section-check the top face of every well where two chamfers meet.

- **Customizer metadata header (requester rule):** the one-file Customizer version must start with `// @name:`, `// @description:`, `// @category:`, `// @credit:`, `// @license:` — in that order, one line each. Not in the skill yet. **Conflict to resolve:** the Project instructions say generated documents carry no licence statements; the requester's pattern requires `@license`. Used `CC BY-SA 4.0` from the requester's pattern; the part file, README and DATASHEET still carry no licence text.

## Warnings and decisions on record
- No §4.1 category. Generic, non-clinical tool approved by the 3D Printing Advisor (owner) as requester.
- Filament on the shelf not stated: designed for PLA as the weaker candidate; PETG listed first.

## Open issues
- Filament on the shelf; zip-tie size; M6 bolt lengths and nut type; quantity and urgency; grip liner wanted?
- Rotation grip is the limiting case (hand estimate): bolts hold 2 kg up to ≈ 0.6 m from the clamp (README: 0.4 m); zip ties up to ≈ 0.1 m. To be confirmed by the 4 kg use test.
- PrusaSlicer dry run (T15) not done in the sandbox: filament and time are estimates.
- Advisor to validate the follow-up schedule and set the readiness levels once the scale file is available.
