MSF3Dprinting/pipe-cross-clamp/tools/sweep_report_gauge_2026-09-26.txt

sweep of ../pipe_cross_clamp.scad — 54 cases — 2026-09-26 07:45
PASS   defaults                                   16.7s  
PASS   part=cap1                                  17.1s  
PASS   part=cap2                                  16.4s  
PASS   part=gauge                                 16.7s  
PASS   closure=zipties                            16.3s  
PASS   pipe1_d=min(10)                            12.5s  
PASS   pipe1_d=max(60)                            17.2s  
PASS   pipe2_d=min(10)                            14.8s  
PASS   pipe2_d=max(60)                            19.3s  
PASS   angle=min(0)                               16.4s  
PASS   angle=max(90)                              16.4s  
PASS   seat_len1=min(20)                          17.2s  
PASS   seat_len1=max(80)                          19.0s  
PASS   seat_len2=min(20)                          19.4s  
PASS   seat_len2=max(80)                          19.3s  
PASS   v_angle=min(60)                            19.8s  
PASS   v_angle=max(90)                            18.9s  
PASS   seat_clear=min(0.5)                        19.4s  
PASS   seat_clear=max(3)                          20.0s  
PASS   clamp_gap=min(1)                           19.3s  
PASS   clamp_gap=max(5)                           19.3s  
PASS   floor_relief=min(0.2)                      19.0s  
PASS   floor_relief=max(2)                        17.9s  
PASS   bolt_clear=min(0.2)                        19.6s  
PASS   bolt_clear=max(1.2)                        19.4s  
PASS   tie_w=min(2.5)                             19.4s  
PASS   tie_w=max(9)                               19.0s  
PASS   tie_t=min(0.8)                             19.4s  
PASS   tie_t=max(2.5)                             18.3s  
PASS   tie_clear=min(0.3)                         19.6s  
PASS   tie_clear=max(1)                           19.7s  
PASS   bolt_d=min(5)                              19.4s  
PASS   bolt_d=max(8)                              19.3s  
PASS   washer_d=min(10)                           19.4s  
PASS   washer_d=max(20)                           19.7s  
PASS   washer_t=min(0.8)                          20.0s  
PASS   washer_t=max(3)                            19.6s  
PASS   nut_h=min(3)                               19.6s  
PASS   nut_h=max(8)                               19.5s  
PASS   web=min(3)                                 19.1s  
PASS   web=max(10)                                19.1s  
PASS   seat_wall=min(1.8)                         19.1s  
PASS   seat_wall=max(6)                           19.5s  
PASS   flange_t=min(4)                            19.8s  
PASS   flange_t=max(10)                           19.4s  
PASS   cap_back=min(3)                            19.6s  
PASS   cap_back=max(10)                           19.8s  
PASS   channel_wall=min(1.8)                      19.7s  
PASS   channel_wall=max(3.6)                      19.2s  
PASS   tie_bend_r=min(5.5)                        19.5s  
PASS   tie_bend_r=max(10)                         19.0s  
PASS   corner_r=min(2)                            19.8s  
PASS   corner_r=max(8)                            19.8s  
PASS   show_ghosts=false                          19.1s  
SUMMARY: 54 PASS, 0 GUARD, 0 FAIL of 54
