MSF3Dprinting/pipe-cross-clamp/img/pipe_cross_clamp_angle30.png

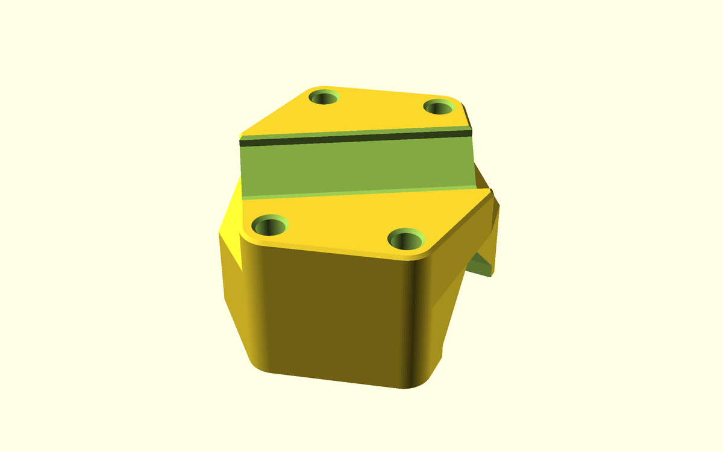
img/pipe_cross_clamp_angle30.png
