MSF3Dprinting/pipe-cross-clamp/img/pipe_cross_clamp_body_bolts_side.png

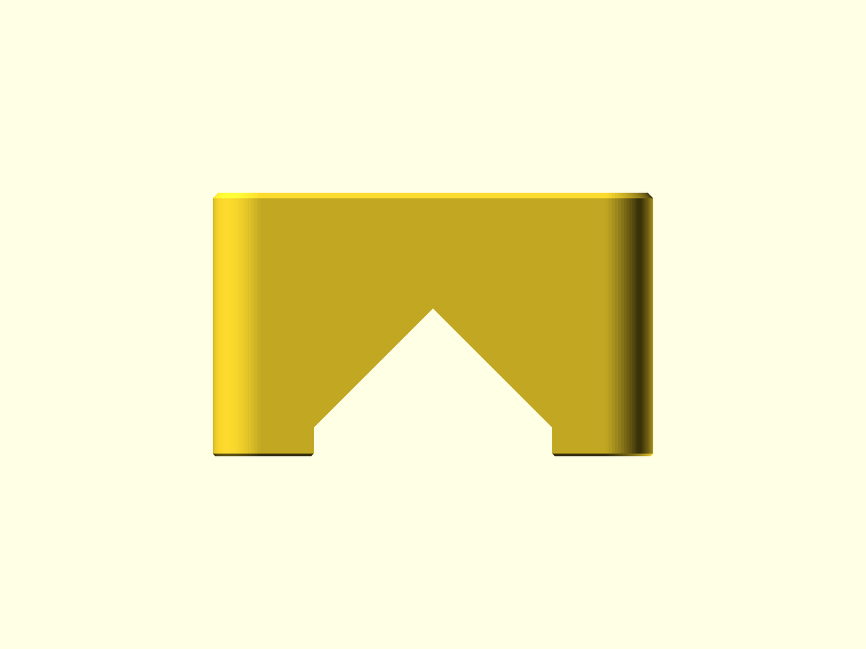
img/pipe_cross_clamp_body_bolts_side.png
