MSF3Dprinting/pipe-cross-clamp/img/pipe_cross_clamp_body_zipties_front.png

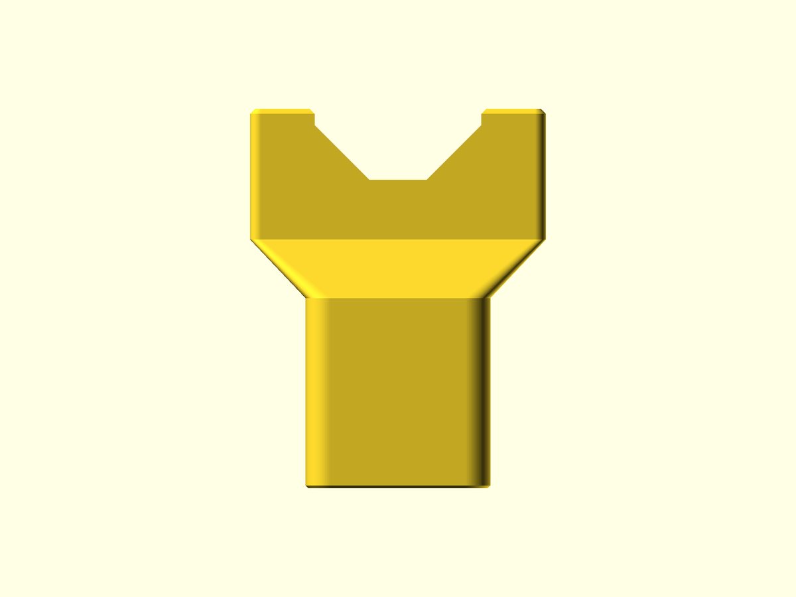
img/pipe_cross_clamp_body_zipties_front.png
