MSF3Dprinting/pipe-cross-clamp/img/pipe_cross_clamp_body_zipties_top.png

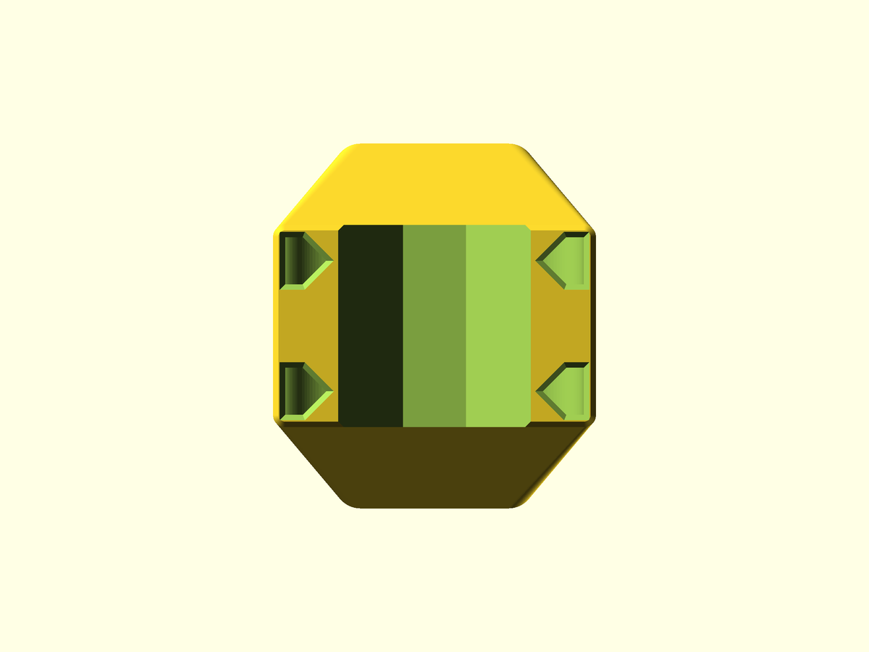
img/pipe_cross_clamp_body_zipties_top.png
