MSF3Dprinting/pipe-cross-clamp/img/pipe_cross_clamp_cap1_front.png

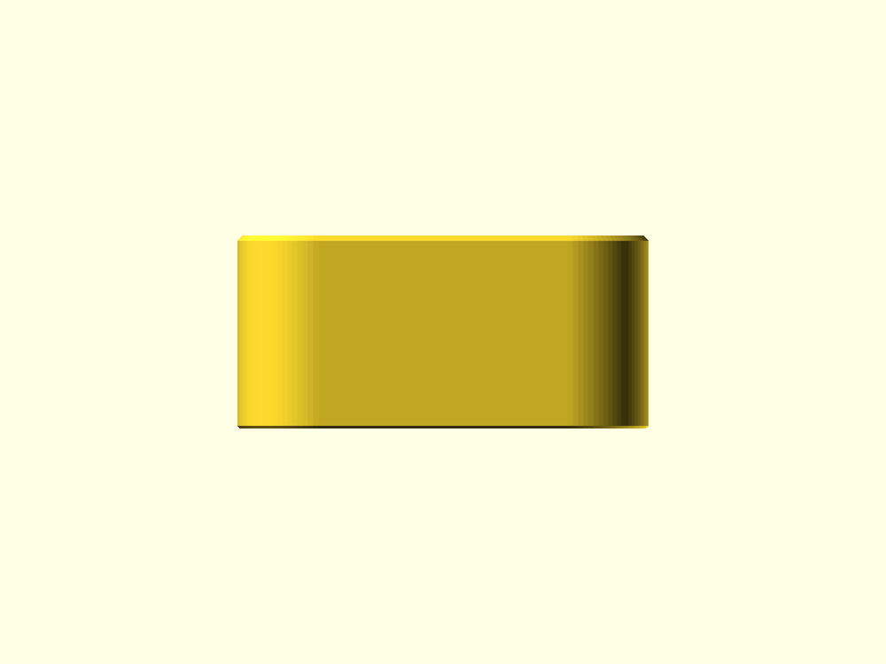
img/pipe_cross_clamp_cap1_front.png
