MSF3Dprinting/pipe-cross-clamp/img/pipe_cross_clamp_cap1_sheet.png

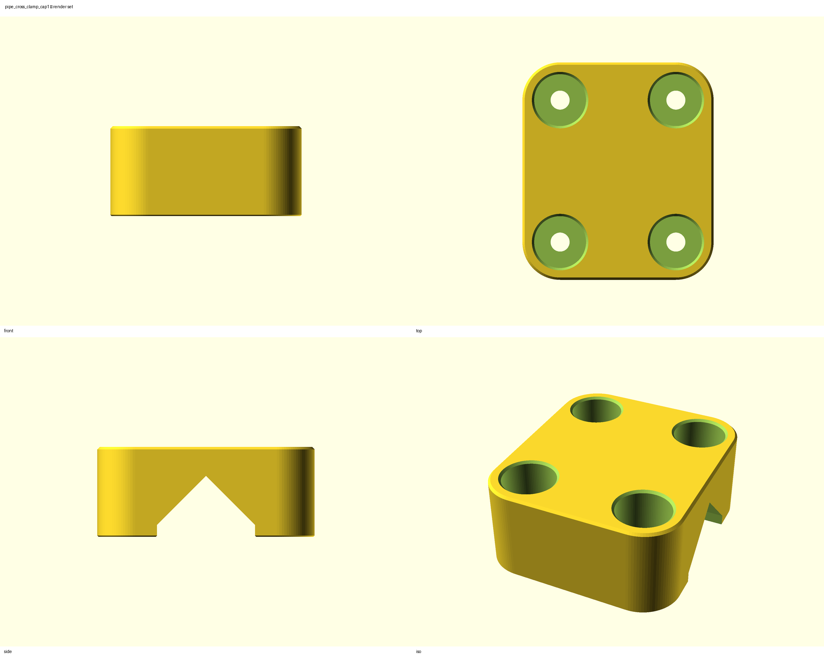
img/pipe_cross_clamp_cap1_sheet.png
