MSF3Dprinting/pipe-cross-clamp/img/pipe_cross_clamp_cap2_iso.png

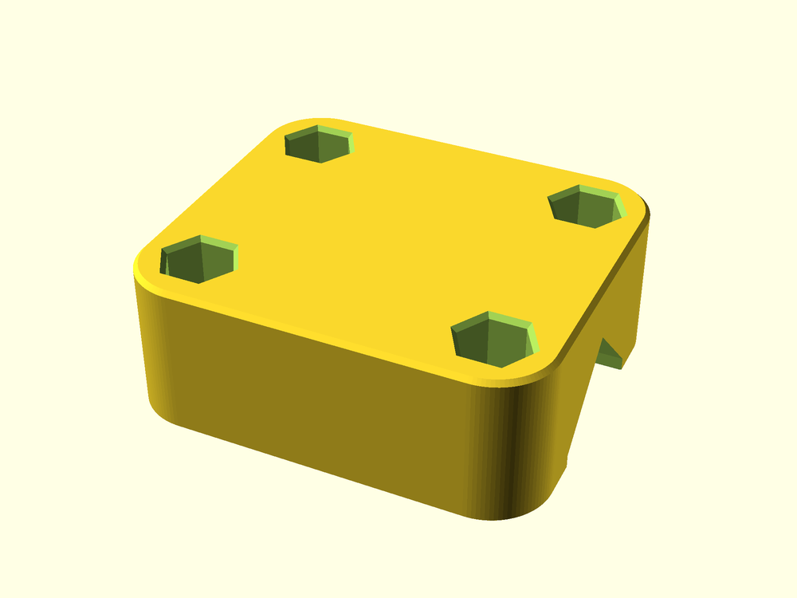
img/pipe_cross_clamp_cap2_iso.png
