MSF3Dprinting/pipe-cross-clamp/img/pipe_cross_clamp_coupon_iso.png

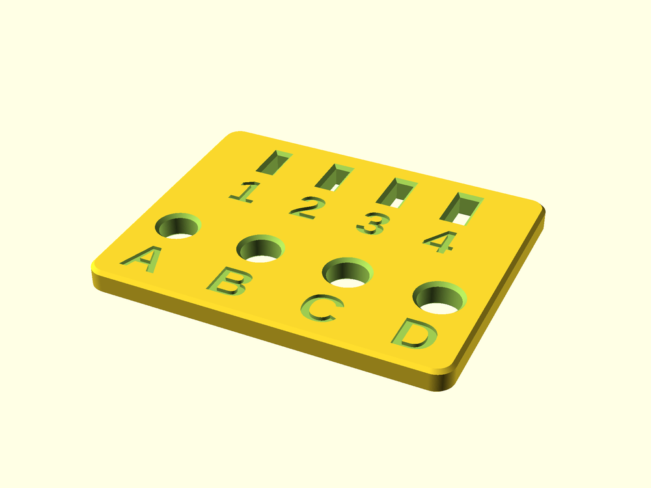
img/pipe_cross_clamp_coupon_iso.png
