MSF3Dprinting/pipe-cross-clamp/img/pipe_cross_clamp_coupon_sheet.png

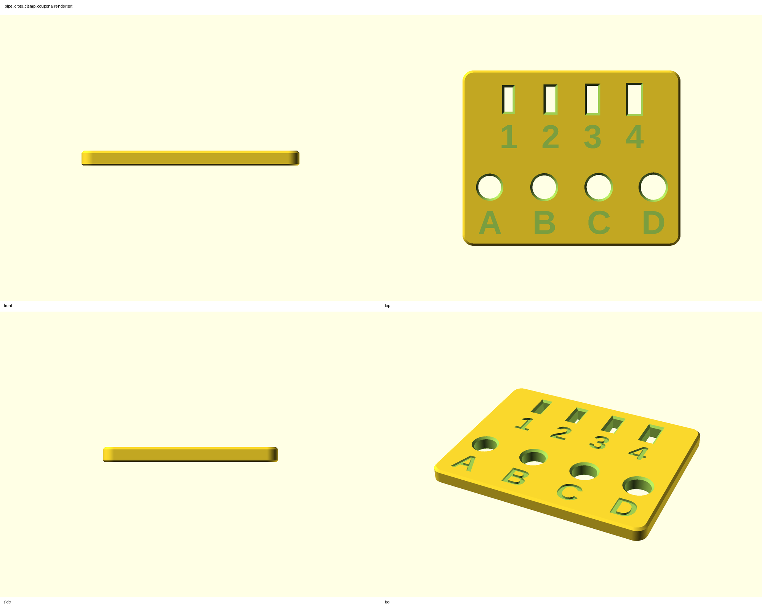
img/pipe_cross_clamp_coupon_sheet.png
