MSF3Dprinting/pipe-cross-clamp/img/pipe_cross_clamp_coupon_side.png

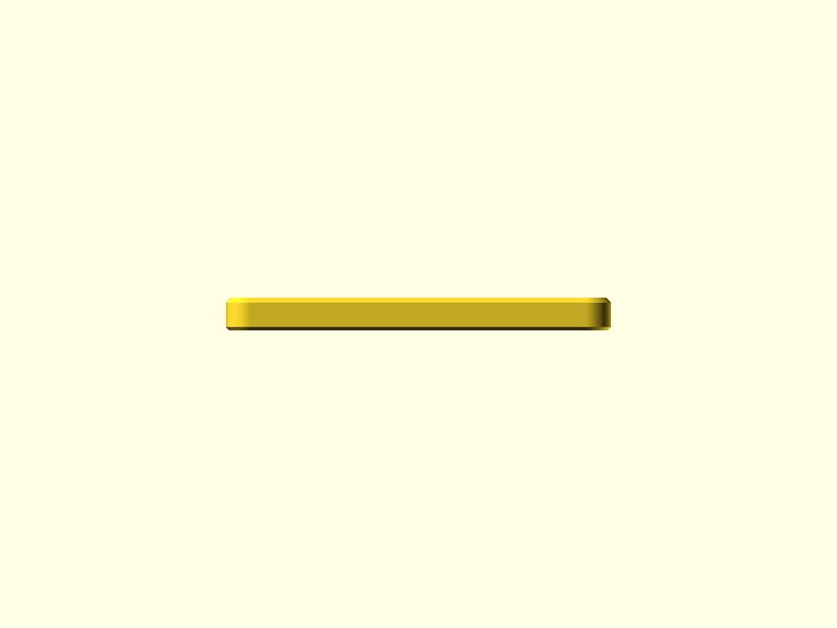
img/pipe_cross_clamp_coupon_side.png
