MSF3Dprinting/pipe-cross-clamp/img/pipe_cross_clamp_coupon_top.png

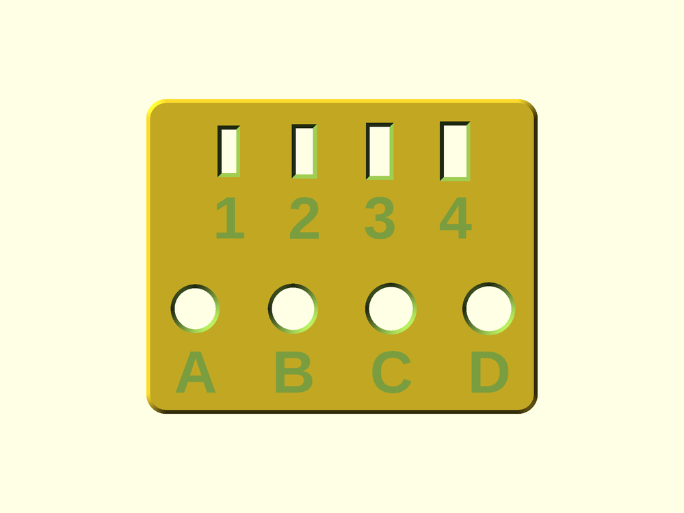
img/pipe_cross_clamp_coupon_top.png
