MSF3Dprinting/pipe-cross-clamp/img/pipe_cross_clamp_max.png

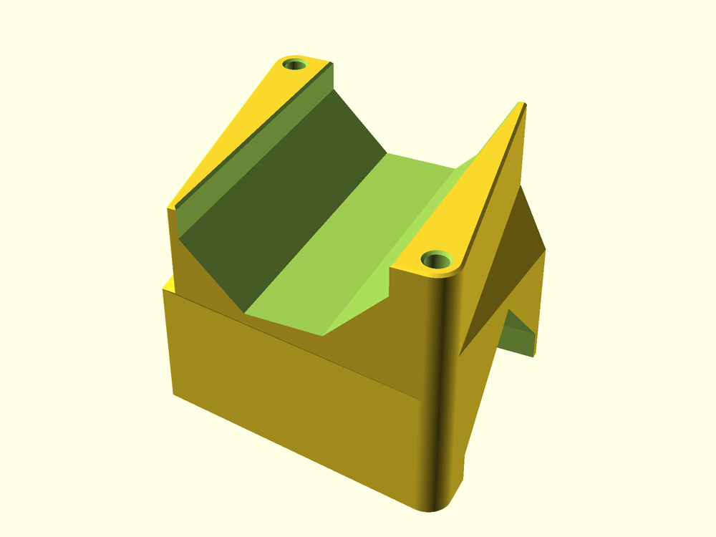
img/pipe_cross_clamp_max.png
