MSF3Dprinting/pipe-cross-clamp/img/pipe_cross_clamp_min.png

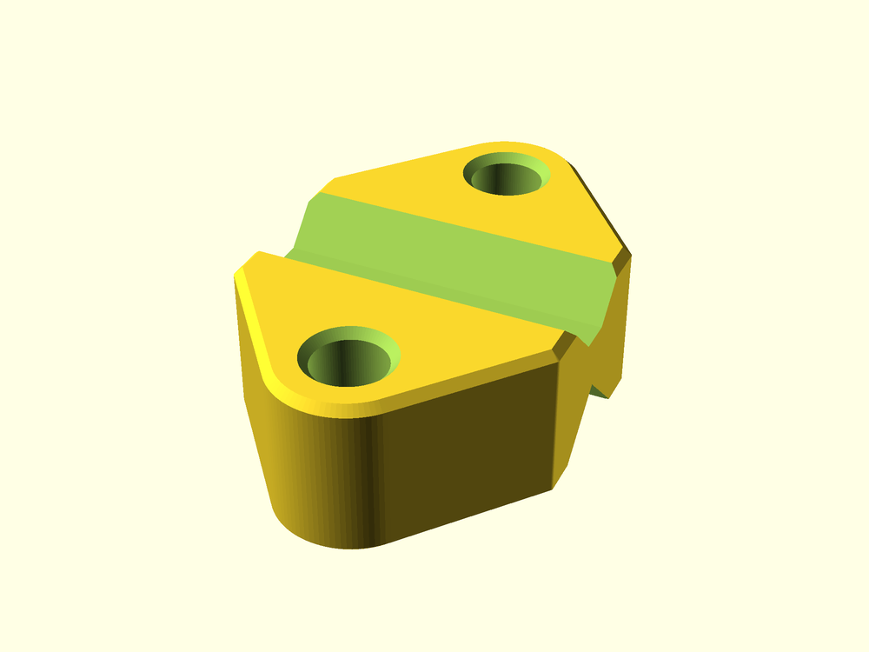
img/pipe_cross_clamp_min.png
