MSF3Dprinting/pipe-cross-clamp/img/pipe_cross_clamp_plate_top.png

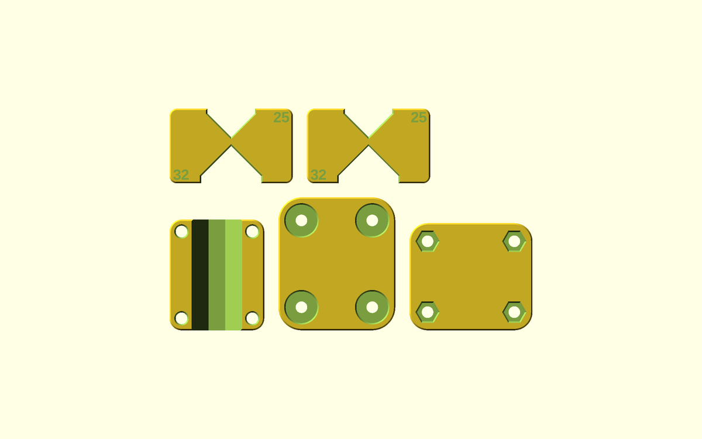
img/pipe_cross_clamp_plate_top.png
