MSF3Dprinting/pipe-cross-clamp/stl/pipe_cross_clamp_coupon_v1.5.stl

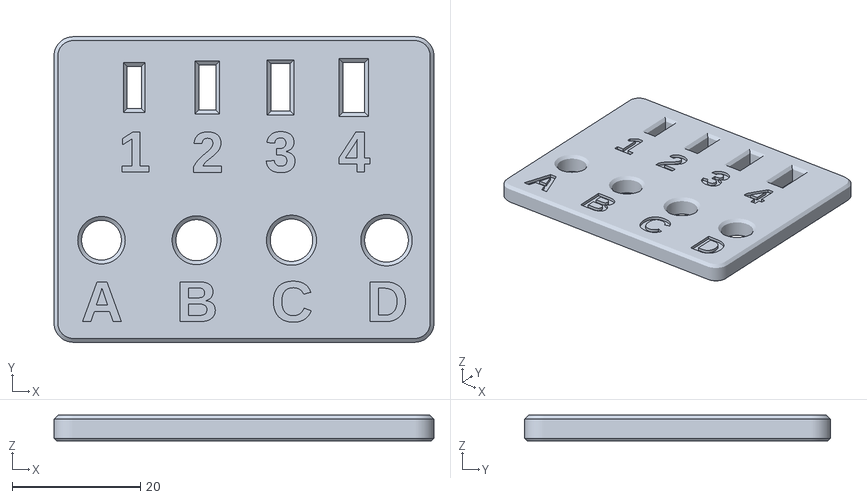
[picture p34: CAD file, 2026-09-27]
stl/pipe_cross_clamp_coupon_v1.5.stl
59.2 x 47.6 x 4.00
