MSF3Dprinting/pipe-cross-clamp/stl/pipe_cross_clamp_cap1_v1.5.stl

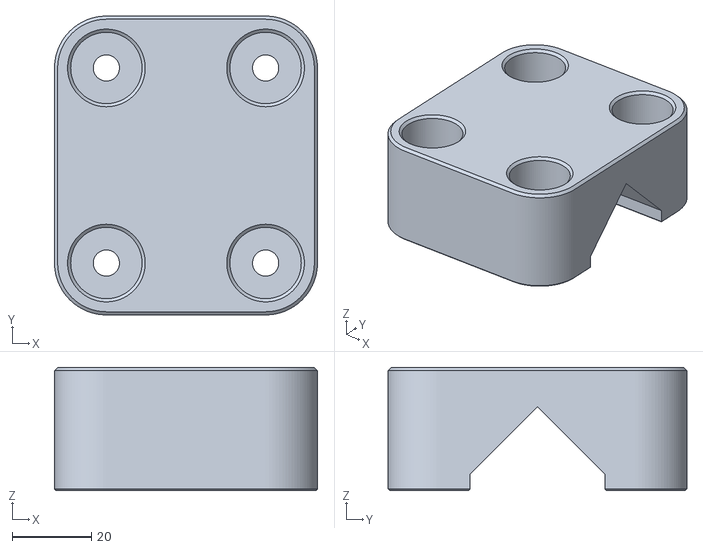
[picture p35: CAD file, 2026-09-27]
stl/pipe_cross_clamp_cap1_v1.5.stl
66.4 x 75.5 x 31.1
