MSF3Dprinting/pipe-cross-clamp/stl/pipe_cross_clamp_plate_zipties_gauges_v1.5.stl

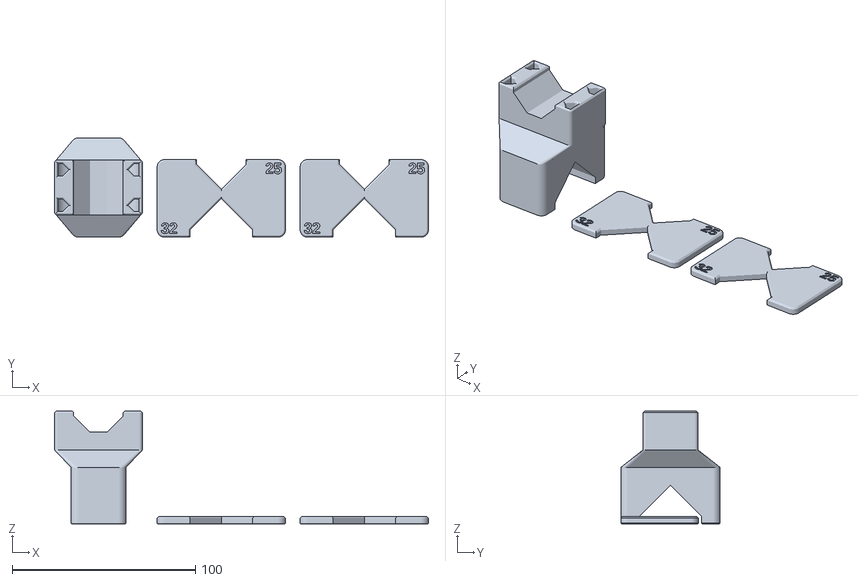
[picture p36: CAD file, 2026-09-27]
stl/pipe_cross_clamp_plate_zipties_gauges_v1.5.stl
204.0 x 54.2 x 61.5
