MSF3Dprinting/pipe-cross-clamp/stl/pipe_cross_clamp_cap2_v1.5.stl

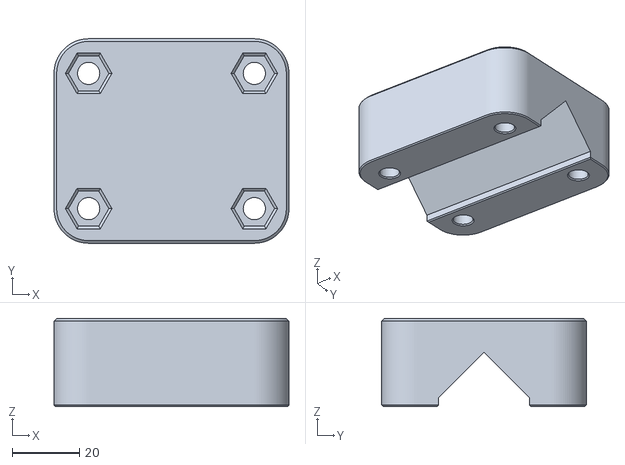
[picture p37: CAD file, 2026-09-27]
stl/pipe_cross_clamp_cap2_v1.5.stl
69.9 x 60.8 x 26.2
