MSF3Dprinting/pipe-cross-clamp/stl/pipe_cross_clamp_body_zipties_v1.5.stl

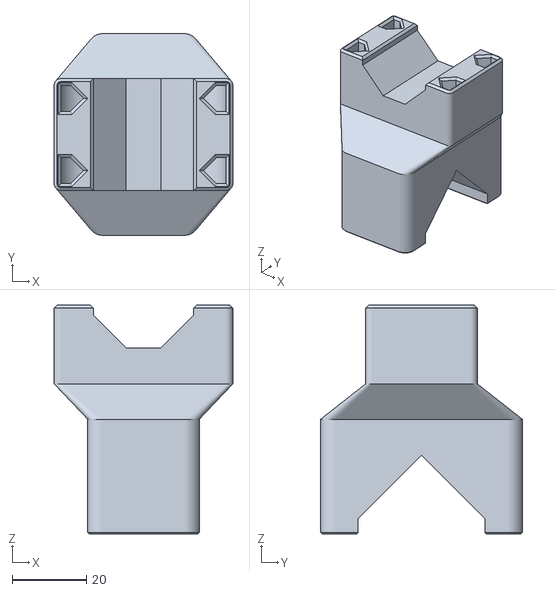
[picture p38: CAD file, 2026-09-27]
stl/pipe_cross_clamp_body_zipties_v1.5.stl
48.0 x 54.2 x 61.5
