MSF3Dprinting/pipe-cross-clamp/stl/pipe_cross_clamp_gauge_1_v1.5.stl

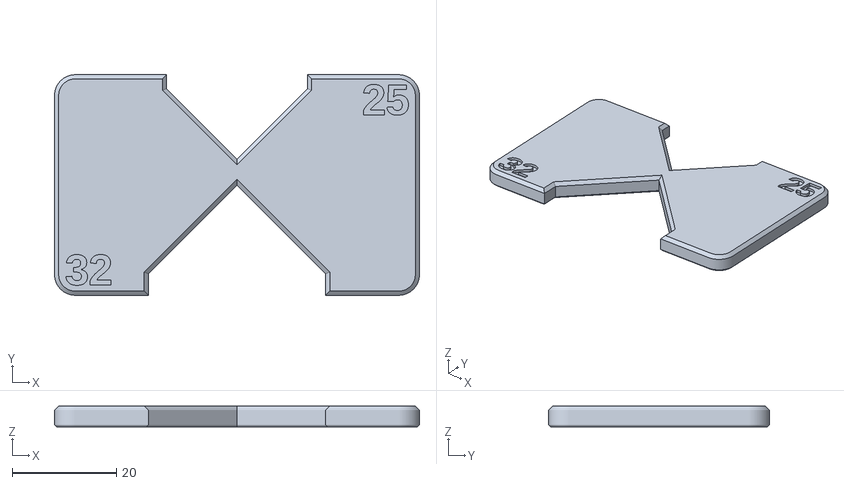
[picture p39: CAD file, 2026-09-27]
stl/pipe_cross_clamp_gauge_1_v1.5.stl
70.0 x 42.3 x 4.00
