MSF3Dprinting/pipe-cross-clamp/stl/pipe_cross_clamp_plate_bolts_v1.5.stl

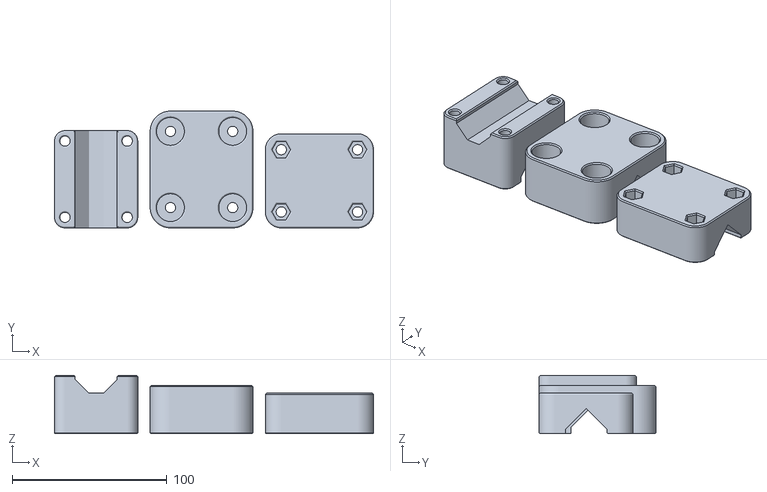
[picture p41: CAD file, 2026-09-27]
stl/pipe_cross_clamp_plate_bolts_v1.5.stl
206.1 x 75.5 x 37.6
