MSF3Dprinting/pipe-cross-clamp/stl/pipe_cross_clamp_body_bolts_v1.5.stl

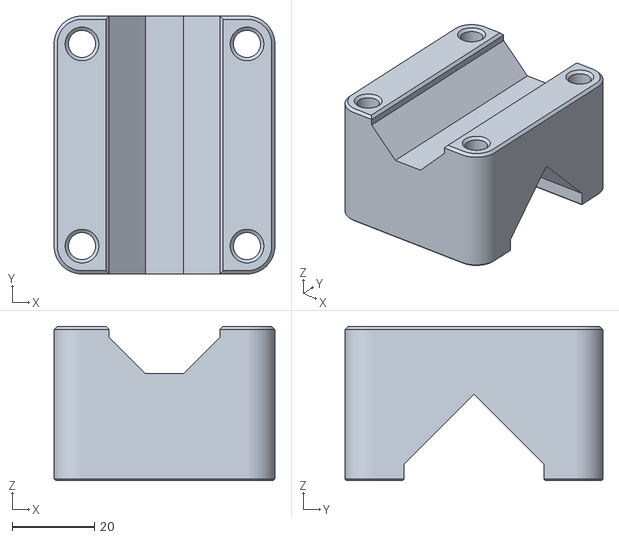
[picture p42: CAD file, 2026-09-27]
stl/pipe_cross_clamp_body_bolts_v1.5.stl
53.8 x 62.9 x 37.6
