MSF3Dprinting/pipe-cross-clamp/(list of files, cad)

Other CAD files:
stl/pipe_cross_clamp_coupon_v1.4.stl
stl/pipe_cross_clamp_plate_zipties_gauges_v1.4.stl
stl/pipe_cross_clamp_cap2_v1.4.stl
stl/pipe_cross_clamp_body_zipties_v1.4.stl
stl/pipe_cross_clamp_cap1_v1.4.stl
stl/pipe_cross_clamp_plate_bolts_v1.4.stl
stl/pipe_cross_clamp_body_bolts_v1.4.stl
stl/pipe_cross_clamp_plate_bolts_gauges_v1.4.stl
pipe_cross_clamp_customizer.scad
